FAhmed1I/Telemetry-Board/README.md

Telemetry Tracking PCB for automotive applications. Designed for testing of automotive projects
