FAhmed1I/Telemetry-Board/LGA-14L_STM.step

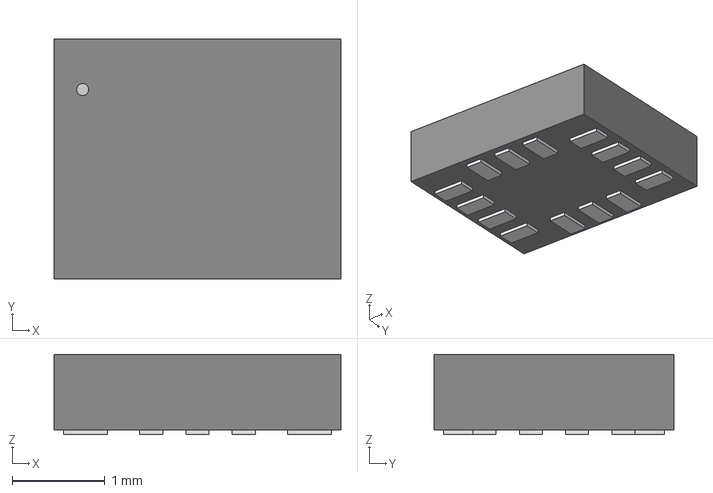
[picture p1: CAD file, 2026-08-17]
LGA-14L_STM.step
3.10 x 2.59 x 0.866 mm
