FAhmed1I/Telemetry-Board/Telemetry Box.kicad_pcb

## KiCad design Telemetry Box.kicad_pcb (2026-09-06)

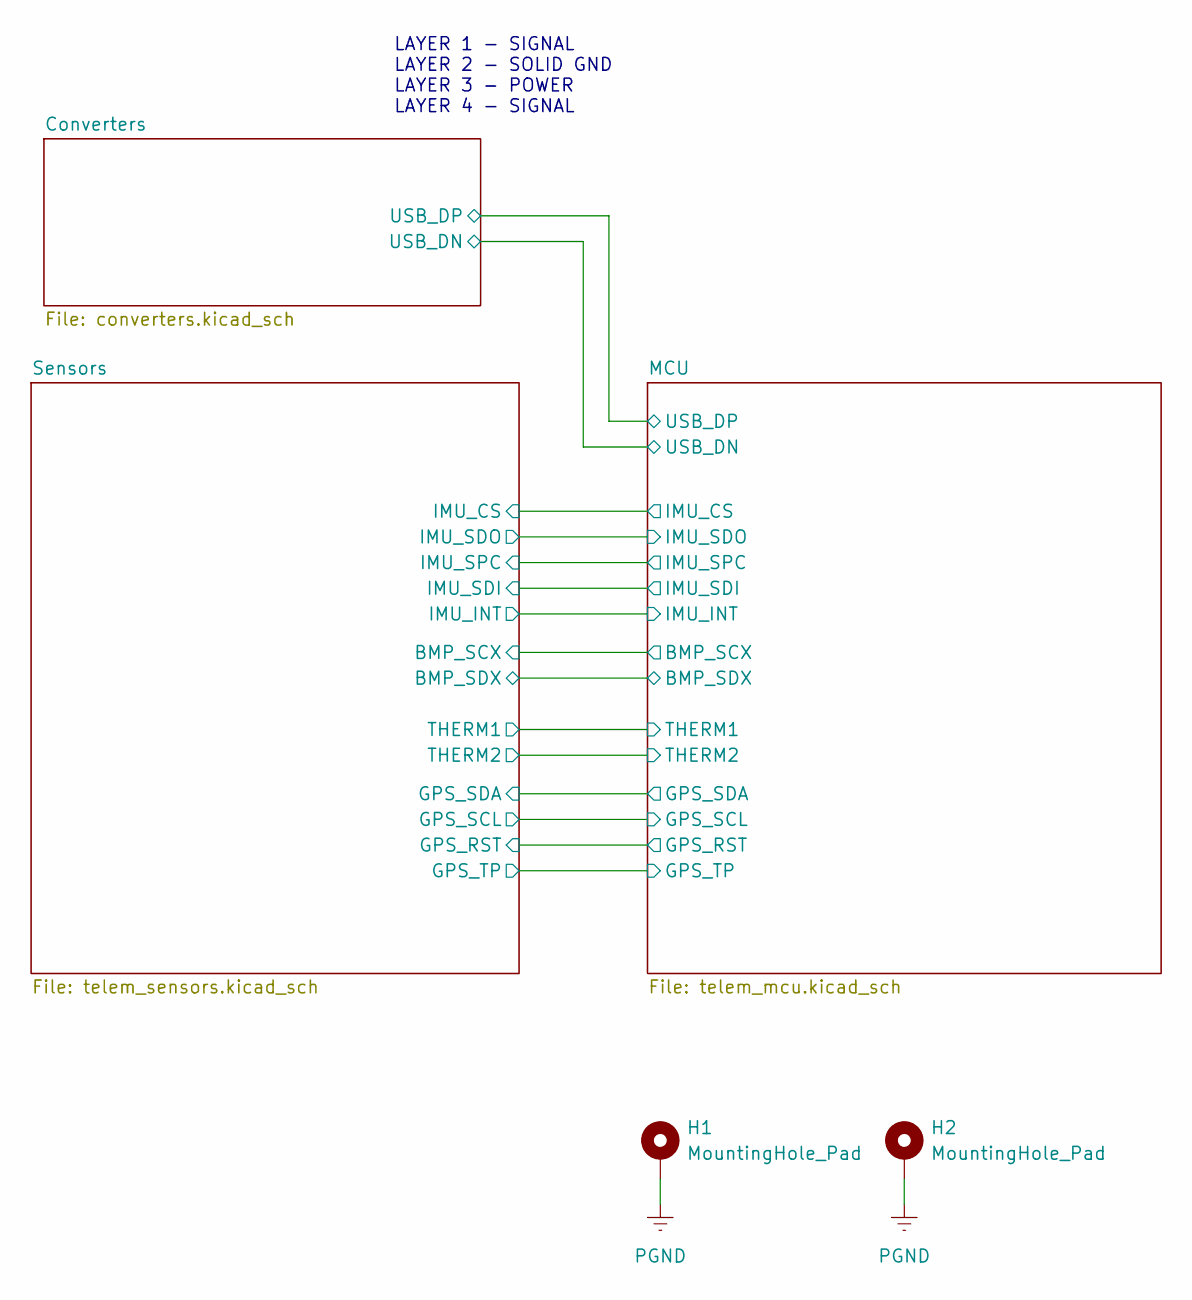
[picture p2: schematic Telemetry Box.kicad_sch]

Parts:
H1, H2: MountingHole_Pad; MountingHole_2.2mm_M2_DIN965_Pad

Connections:
PGND: H1.1 (1_1), H2.1 (1_1); also elsewhere on the board

Notes on the sheet:
LAYER 1 - SIGNAL LAYER 2 - SOLID GND LAYER 3 - POWER LAYER 4 - SIGNAL

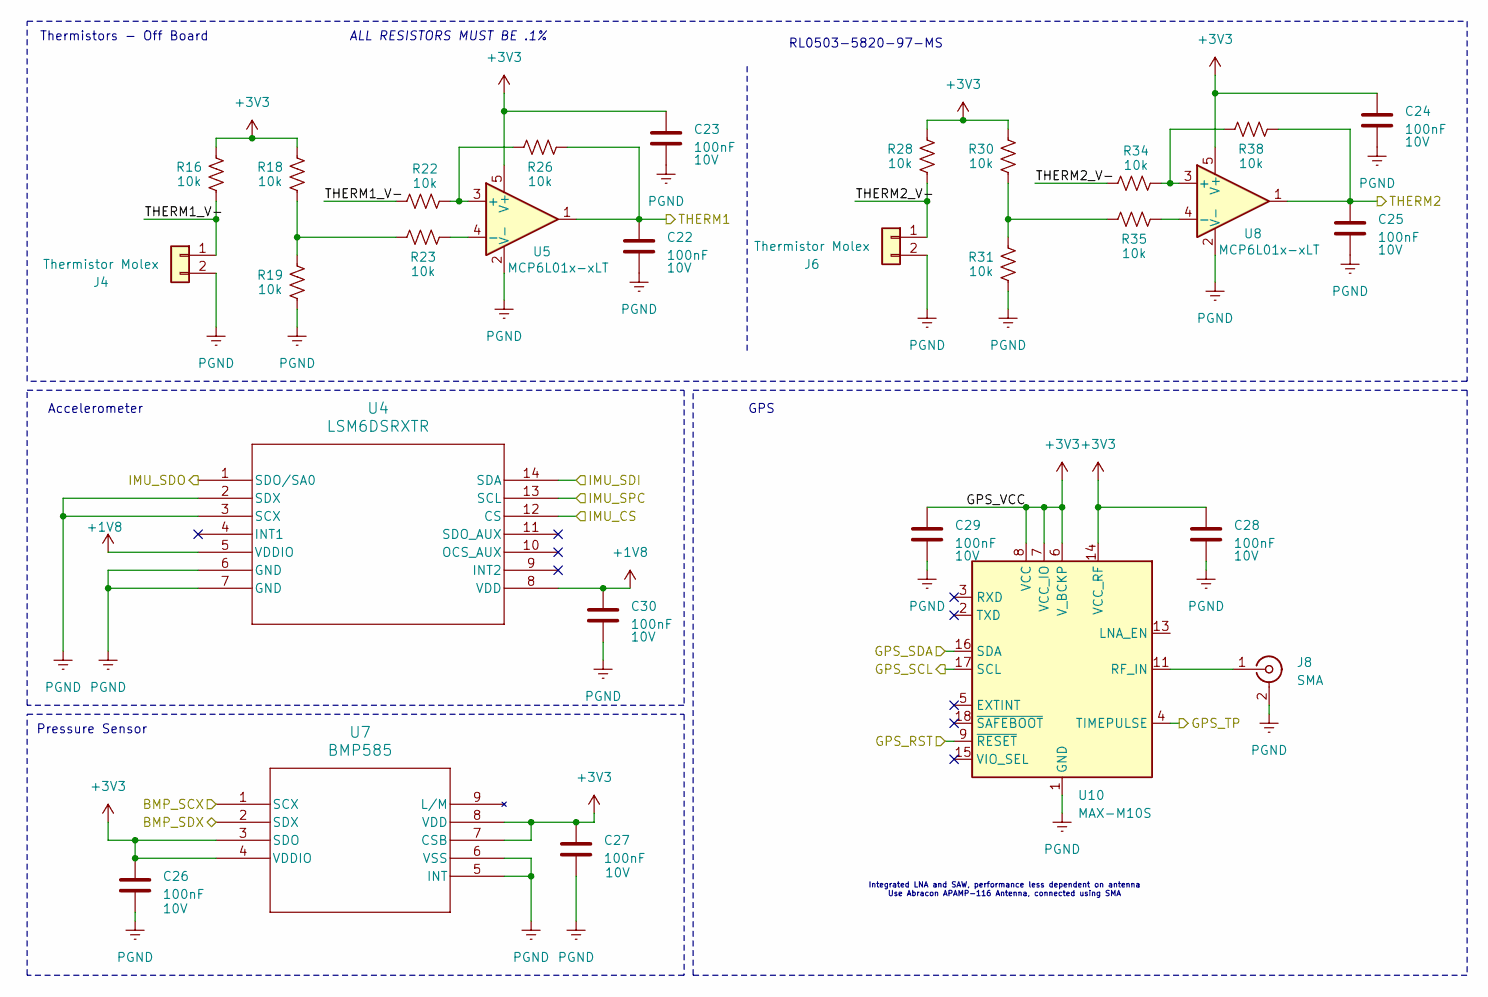
[picture p3: schematic telem_sensors.kicad_sch]

Parts:
C22, C23, C24, C25, C26, C27, C28, C29, C30: 100nF; C_0603_1608Metric; Voltage Rating 10V
J4, J6: Thermistor Molex; Molex_MicroClasp_55932-0230_1x02_P2.00mm_Vertical
J8: SMA; SMA_Amphenol_132289_EdgeMount
R16, R18, R19, R22, R23, R26, R28, R30, R31, R34, R35, R38: 10k; R_0603_1608Metric
U4: LSM6DSRXTR; LGA-14L_STM
U5, U8: MCP6L01x-xLT; SOT-353_SC-70-5
U7: BMP585; LGA9_BMP585_BOS
U10: MAX-M10S; ublox_MAX

Connections:
+1V8: C30.1, U4.5 (VDDIO), U4.8 (VDD); also elsewhere on the board
+3V3: C23.1, C24.1, C26.1, C27.1, C28.1, C29.1, R16.2, R18.2, R28.2, R30.2, U5.5 (V+), U7.3 (SDO), U7.4 (VDDIO), U7.7 (CSB), U7.8 (VDD), U8.5 (V+), U10.6 (V_BCKP), U10.7 (VCC_IO), U10.8 (VCC), U10.14 (VCC_RF); also elsewhere on the board
/MCU/BMP_SCX: U7.1 (SCX); also elsewhere on the board
/MCU/BMP_SDX: U7.2 (SDX); also elsewhere on the board
/MCU/GPS_RST: U10.9 (~RESET); also elsewhere on the board
/MCU/GPS_SCL: U10.17 (SCL); also elsewhere on the board
/MCU/GPS_SDA: U10.16 (SDA); also elsewhere on the board
/MCU/GPS_TP: U10.4 (TIMEPULSE); also elsewhere on the board
/MCU/IMU_CS: U4.12 (CS); also elsewhere on the board
/MCU/IMU_SDI: U4.14 (SDA); also elsewhere on the board
/MCU/IMU_SDO: U4.1 (SDO/SA0); also elsewhere on the board
/MCU/IMU_SPC: U4.13 (SCL); also elsewhere on the board
/MCU/THERM1: C22.1, R26.1, U5.1; also elsewhere on the board
/MCU/THERM2: C25.1, R38.1, U8.1; also elsewhere on the board
/Sensors/THERM1_V-: J4.1, R16.1, R22.2
/Sensors/THERM2_V-: J6.1, R28.1, R34.2
unnamed: J8.1 (In), U10.11 (RF_IN)
unnamed: R18.1, R19.2, R23.2
unnamed: R30.1, R31.2, R35.2
unnamed: R22.1, R26.2, U5.3 (+)
unnamed: R23.1, U5.4 (-)
unnamed: R34.1, R38.2, U8.3 (+)
unnamed: R35.1, U8.4 (-)
PGND: C22.2, C23.2, C24.2, C25.2, C26.2, C27.2, C28.2, C29.2, C30.2, J4.2, J6.2, J8.2 (Ext), R19.1, R31.1, U4.2 (SDX), U4.3 (SCX), U4.6 (GND), U4.7 (GND), U5.2 (V-), U7.5 (INT), U7.6 (VSS), U8.2 (V-), U10.1 (GND), U10.10 (GND), U10.12 (GND); also elsewhere on the board

Notes on the sheet:
RL0503-5820-97-MS
Thermistors - Off Board
Accelerometer
GPS
Integrated LNA and SAW, performance less dependent on antenna Use Abracon APAMP-116 Antenna, connected using SMA
ALL RESISTORS MUST BE .1%
Pressure Sensor

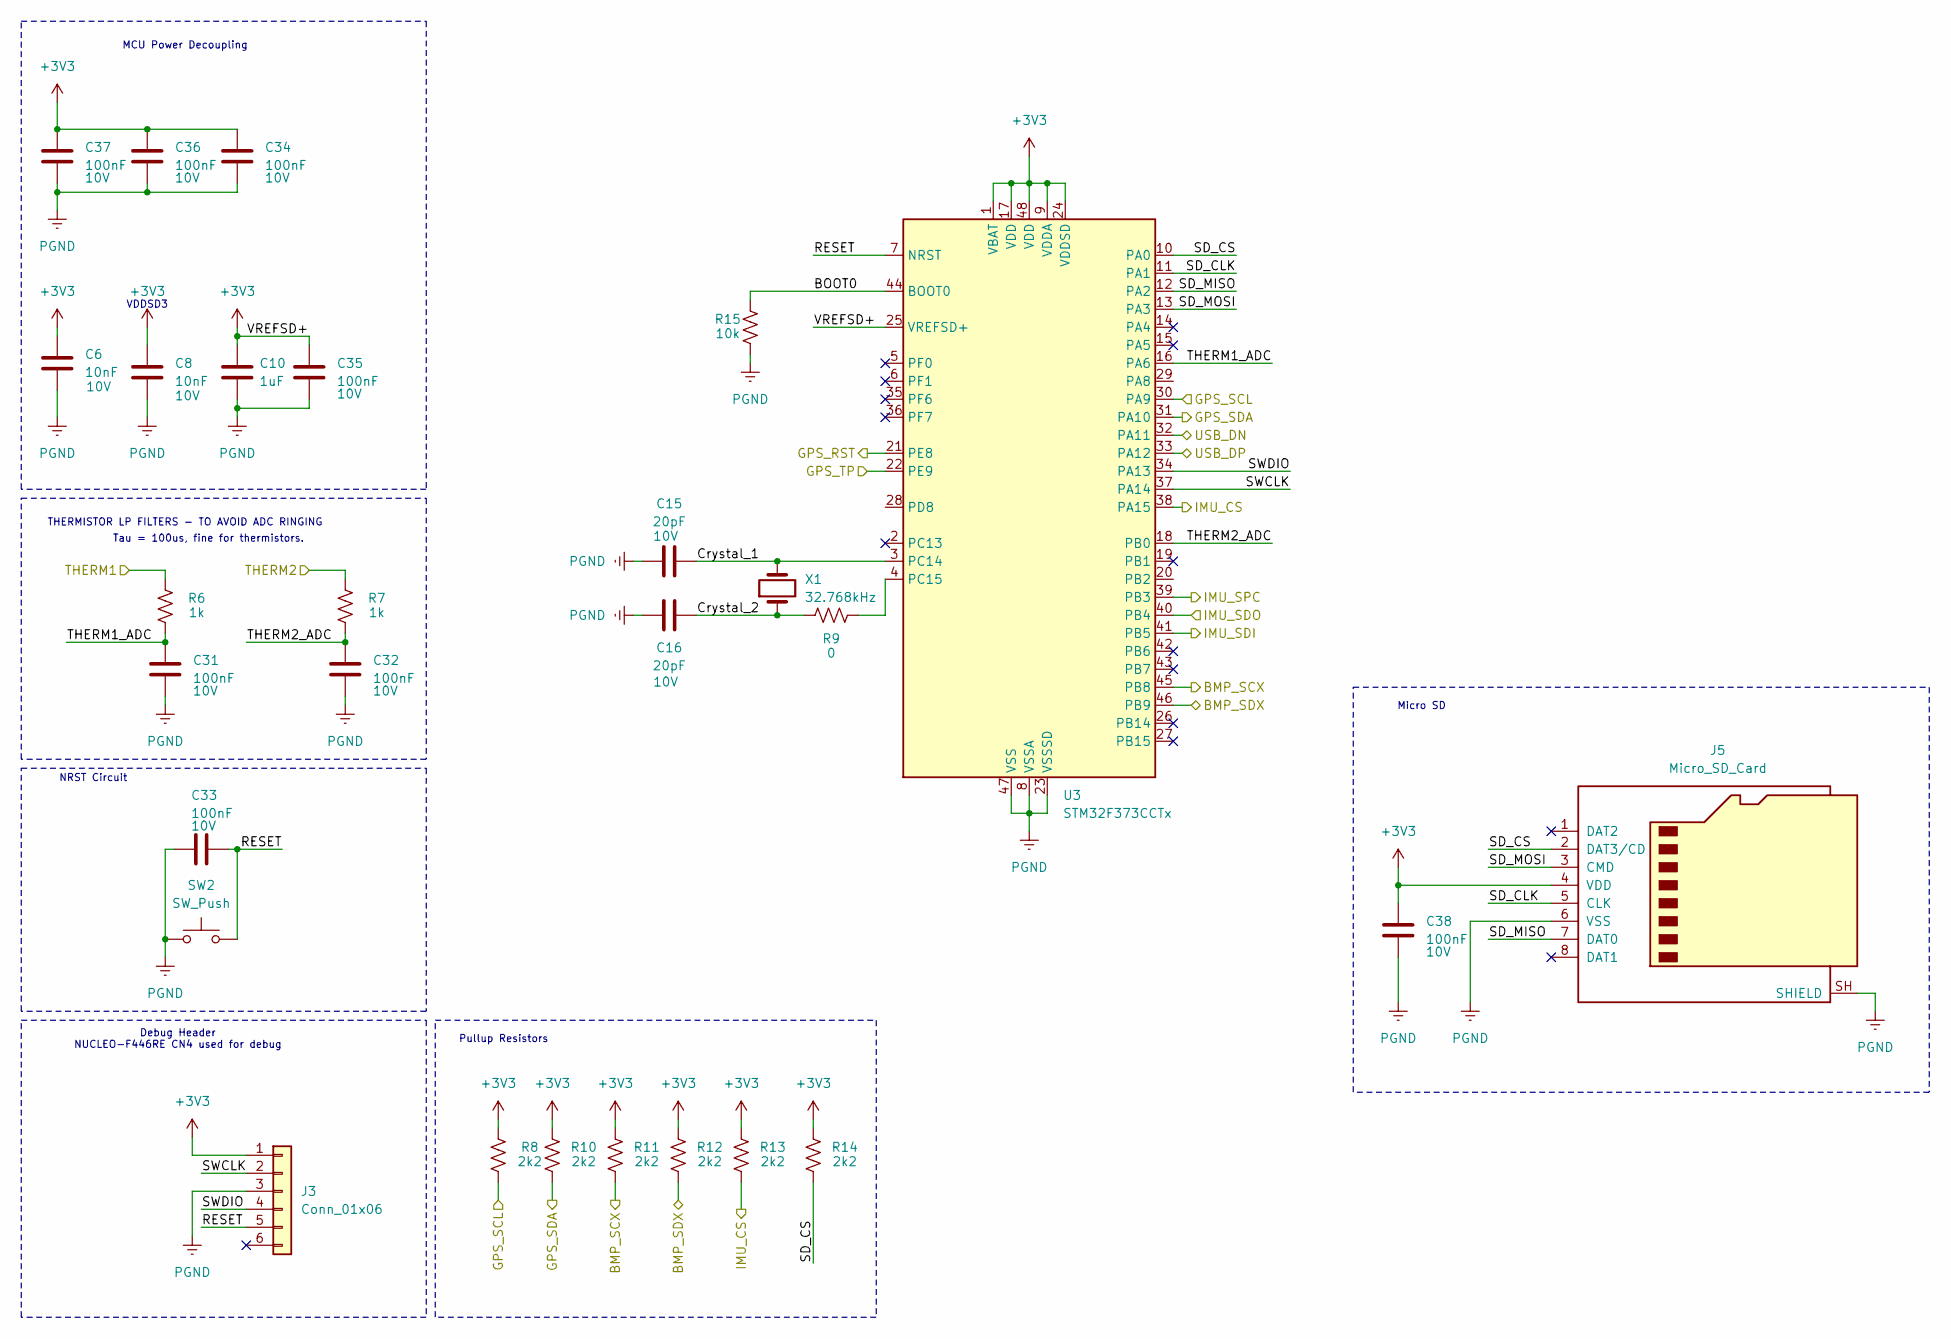
[picture p4: schematic telem_mcu.kicad_sch]

Parts:
C6, C8: 10nF; C_0603_1608Metric; Voltage Rating 10V
C10: 1uF; C_0603_1608Metric; Voltage Rating 10V
C15, C16: 20pF; C_0603_1608Metric; Voltage Rating 10V
C31, C32, C33, C34, C35, C36, C37, C38: 100nF; C_0603_1608Metric; Voltage Rating 10V
J3: Conn_01x06; PinHeader_1x06_P2.54mm_Vertical_SMD_Pin1Right
J5: Micro_SD_Card; AMPHENOL_10067099-200LF
R6, R7: 1k; R_0603_1608Metric
R8, R10, R11, R12, R13, R14: 2k2; R_0603_1608Metric
R9: 0; R_0603_1608Metric
R15: 10k; R_0603_1608Metric
SW2: SW_Push; SW_EVP-AWED4A
U3: STM32F373CCTx; LQFP-48_7x7mm_P0.5mm
X1: 32.768kHz; Crystal_SMD_3215-2Pin_3.2x1.5mm

Connections:
+3V3: C6.1, C8.1, C10.1, C34.1, C35.1, C36.1, C37.1, C38.1, J3.1, J5.4 (VDD), R8.2, R10.2, R11.2, R12.2, R13.2, R14.2, U3.1 (VBAT), U3.9 (VDDA), U3.17 (VDD), U3.24 (VDDSD), U3.25 (VREFSD+), U3.48 (VDD); also elsewhere on the board
/Converters/USB_DN: U3.32 (PA11); also elsewhere on the board
/Converters/USB_DP: U3.33 (PA12); also elsewhere on the board
/MCU/BMP_SCX: R11.1, U3.45 (PB8); also elsewhere on the board
/MCU/BMP_SDX: R12.1, U3.46 (PB9); also elsewhere on the board
/MCU/BOOT0: R15.2, U3.44 (BOOT0)
/MCU/Crystal_1: C15.2, U3.3 (PC14), X1.2
/MCU/Crystal_2: C16.2, R9.1, X1.1
/MCU/GPS_RST: U3.21 (PE8); also elsewhere on the board
/MCU/GPS_SCL: R8.1, U3.30 (PA9); also elsewhere on the board
/MCU/GPS_SDA: R10.1, U3.31 (PA10); also elsewhere on the board
/MCU/GPS_TP: U3.22 (PE9); also elsewhere on the board
/MCU/IMU_CS: R13.1, U3.38 (PA15); also elsewhere on the board
/MCU/IMU_SDI: U3.41 (PB5); also elsewhere on the board
/MCU/IMU_SDO: U3.40 (PB4); also elsewhere on the board
/MCU/IMU_SPC: U3.39 (PB3); also elsewhere on the board
/MCU/RESET: C33.2, J3.5, SW2.2, U3.7 (NRST)
/MCU/SD_CLK: J5.5 (CLK), U3.11 (PA1)
/MCU/SD_CS: J5.2 (DAT3/CD), R14.1, U3.10 (PA0)
/MCU/SD_MISO: J5.7 (DAT0), U3.12 (PA2)
/MCU/SD_MOSI: J5.3 (CMD), U3.13 (PA3)
/MCU/SWCLK: J3.2, U3.37 (PA14)
/MCU/SWDIO: J3.4, U3.34 (PA13)
/MCU/THERM1: R6.2; also elsewhere on the board
/MCU/THERM1_ADC: C31.1, R6.1, U3.16 (PA6)
/MCU/THERM2: R7.2; also elsewhere on the board
/MCU/THERM2_ADC: C32.1, R7.1, U3.18 (PB0)
unnamed: R9.2, U3.4 (PC15)
PGND: C6.2, C8.2, C10.2, C15.1, C16.1, C31.2, C32.2, C33.1, C34.2, C35.2, C36.2, C37.2, C38.2, J3.3, J5.6 (VSS), J5.SH (SHIELD), R15.1, SW2.1, U3.8 (VSSA), U3.23 (VSSSD), U3.47 (VSS); also elsewhere on the board

Notes on the sheet:
Debug Header NUCLEO-F446RE CN4 used for debug
VDDSD3
THERMISTOR LP FILTERS - TO AVOID ADC RINGING
MCU Power Decoupling
Pullup Resistors
Micro SD
NRST Circuit
Tau = 100us, fine for thermistors.

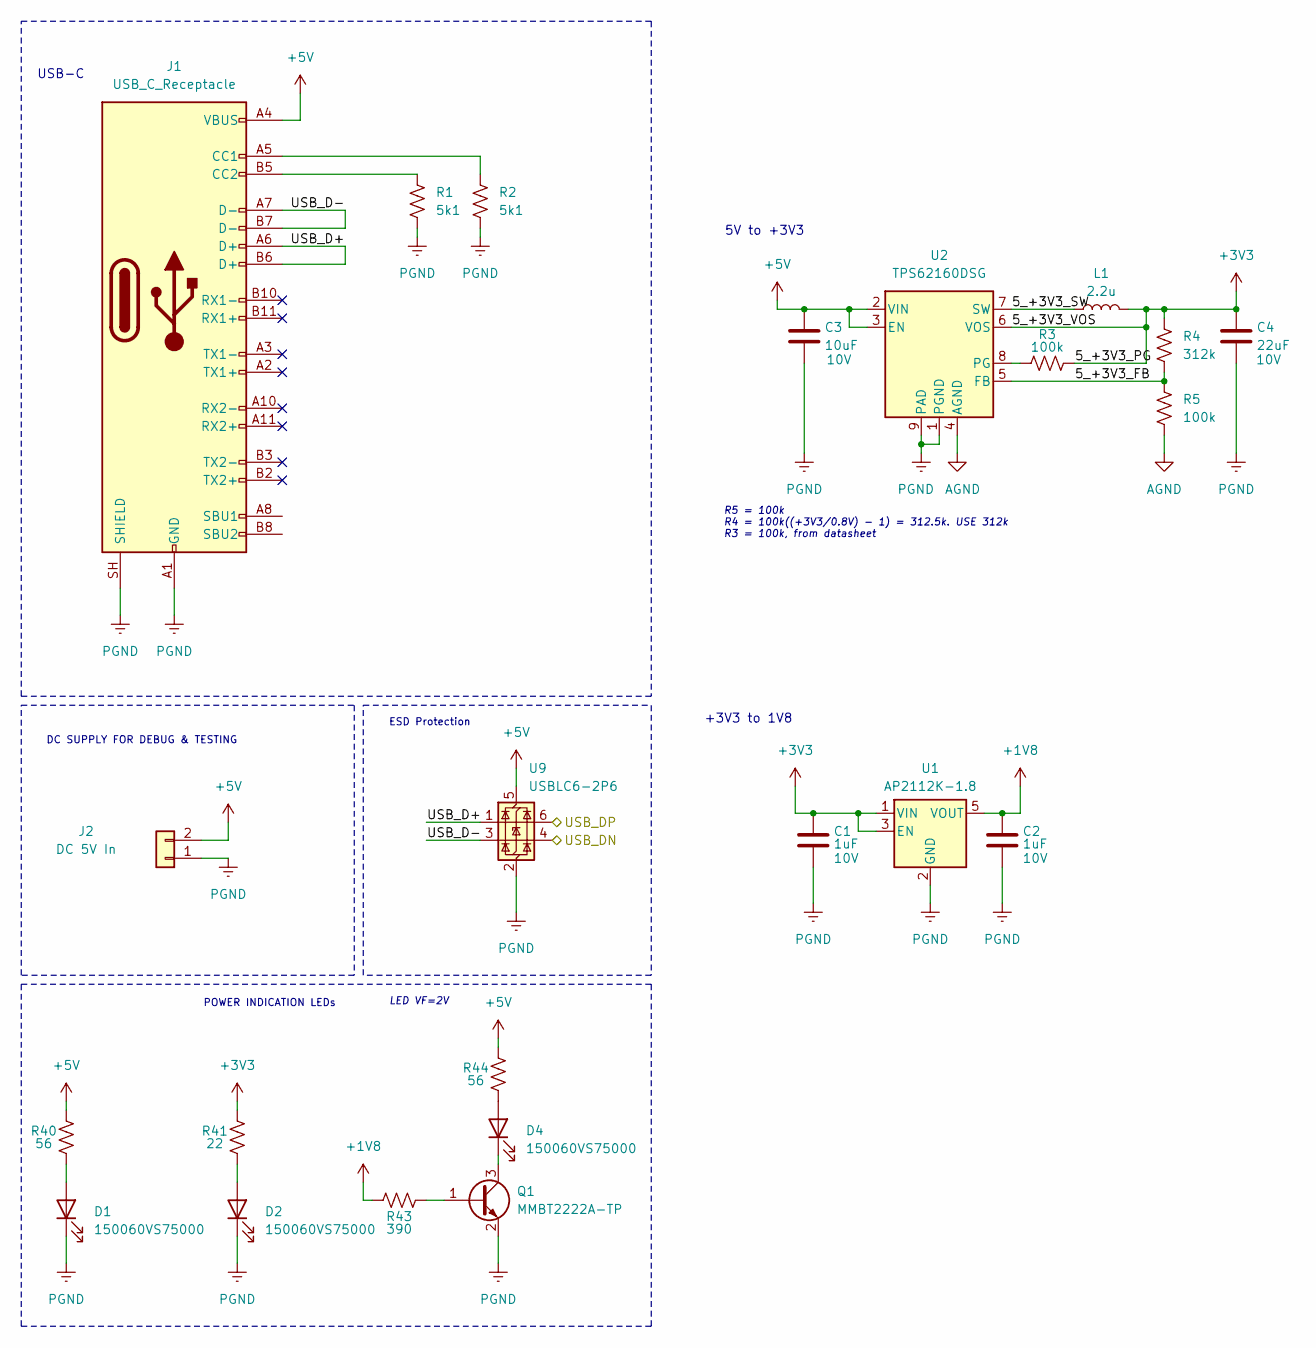
[picture p5: schematic converters.kicad_sch]

Parts:
C1, C2: 1uF; C_0603_1608Metric; Voltage Rating 10V
C3: 10uF; C_0603_1608Metric; Voltage Rating 10V
C4: 22uF; C_0603_1608Metric; Voltage Rating 10V
D1, D2, D4: 150060VS75000; LED_0603_1608Metric
J1: USB_C_Receptacle; USB_C_Receptacle_Amphenol_12401610E4-2A
J2: DC 5V In; PinHeader_1x02_P2.00mm_Vertical
L1: 2.2u; L_1008_2520Metric
Q1: MMBT2222A-TP; SOT-23-3
R1, R2: 5k1; R_0805_2012Metric_Pad1.20x1.40mm_HandSolder
R3, R5: 100k; R_0805_2012Metric_Pad1.20x1.40mm_HandSolder
R4: 312k; R_0805_2012Metric_Pad1.20x1.40mm_HandSolder
R40, R44: 56; R_0603_1608Metric
R41: 22; R_0603_1608Metric
R43: 390; R_0603_1608Metric
U1: AP2112K-1.8; SOT-23-5
U2: TPS62160DSG; WSON-8-1EP_2x2mm_P0.5mm_EP0.9x1.6mm_ThermalVias
U9: USBLC6-2P6; SOT-666

Connections:
+1V8: C2.1, R43.2, U1.5 (VOUT); also elsewhere on the board
+3V3: C1.1, C4.1, L1.2, R3.2, R4.1, R41.2, U1.1 (VIN), U1.3 (EN), U2.6 (VOS); also elsewhere on the board
+5V: C3.1, J1.A4 (VBUS), J1.A9 (VBUS), J1.B4 (VBUS), J1.B9 (VBUS), J2.2, R40.2, R44.2, U2.2 (VIN), U2.3 (EN), U9.5 (VBUS)
/Converters/5_+3V3_FB: R4.2, R5.1, U2.5 (FB)
/Converters/5_+3V3_SW: L1.1, U2.7 (SW)
/Converters/USB_D+: J1.A6 (D+), J1.B6 (D+), U9.1 (I/O1)
/Converters/USB_D-: J1.A7 (D-), J1.B7 (D-), U9.3 (I/O2)
/Converters/USB_DN: U9.4 (I/O2); also elsewhere on the board
/Converters/USB_DP: U9.6 (I/O1); also elsewhere on the board
AGND: R5.2, U2.4 (AGND)
unnamed: D1.2 (A), R40.1
unnamed: D2.2 (A), R41.1
unnamed: D4.2 (A), R44.1
unnamed: D4.1 (K), Q1.3 (C)
unnamed: J1.A5 (CC1), R2.1
unnamed: J1.B5 (CC2), R1.1
unnamed: Q1.1 (B), R43.1
unnamed: R3.1, U2.8 (PG)
PGND: C1.2, C2.2, C3.2, C4.2, D1.1 (K), D2.1 (K), J1.A1 (GND), J1.A12 (GND), J1.B1 (GND), J1.B12 (GND), J1.SH (SHIELD), J2.1, Q1.2 (E), R1.2, R2.2, U1.2 (GND), U2.1 (PGND), U2.9 (PAD), U9.2 (GND); also elsewhere on the board

Notes on the sheet:
+3V3 to 1V8
R5 = 100k R4 = 100k((+3V3/0.8V) - 1) = 312.5k. USE 312k R3 = 100k, from datasheet
LED VF=2V
USB-C
5V to +3V3
DC SUPPLY FOR DEBUG & TESTING
POWER INDICATION LEDs
ESD Protection

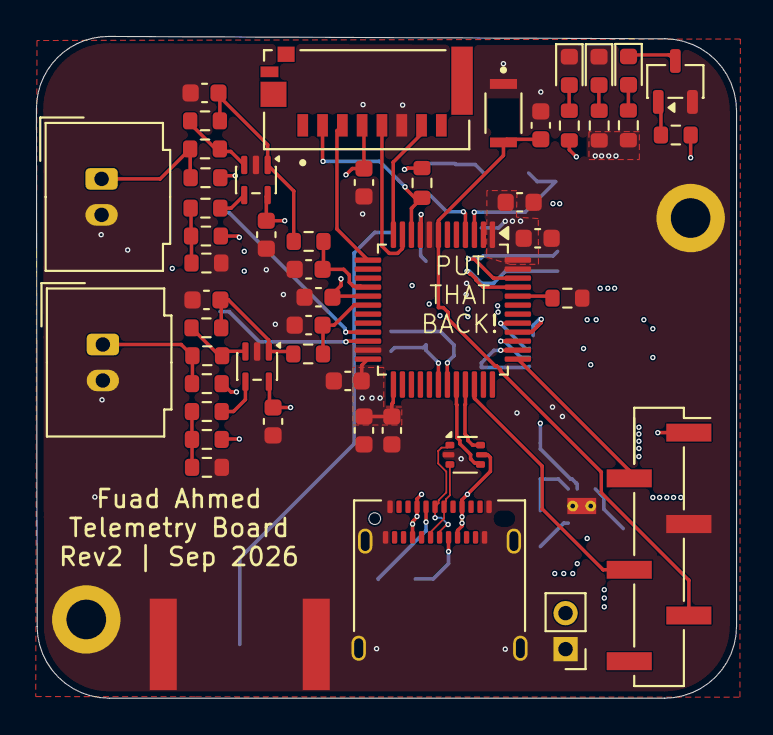
[picture p6: board Telemetry Box.kicad_pcb from above]

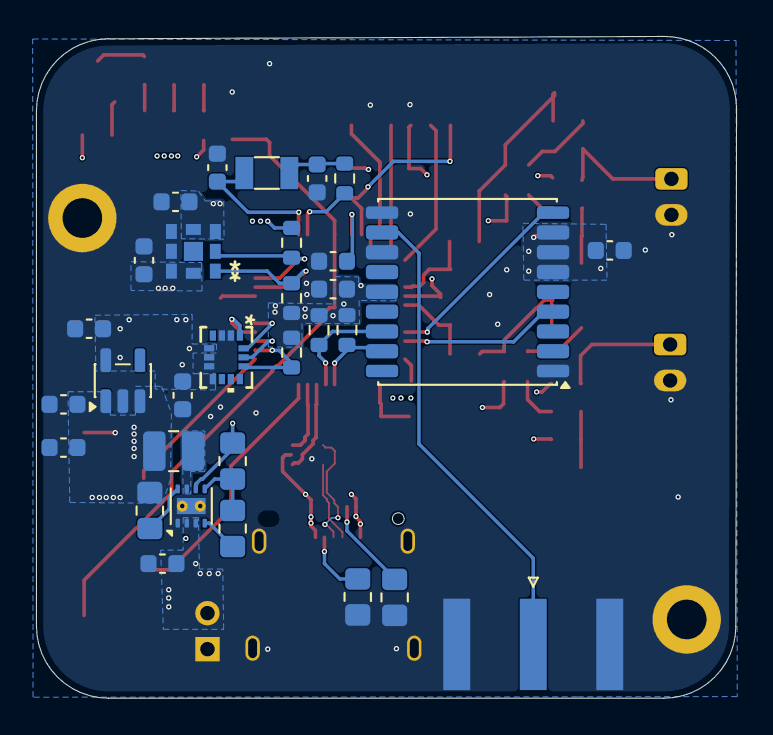
[picture p7: board Telemetry Box.kicad_pcb from below]

Board: 4 copper layers, 38.9 x 36.8 mm, 82 parts (31 on the bottom side), 53 nets.
