FAhmed1I/Telemetry-Board/(commit log)

2026-08-19 Added MAX-M10S GPS, selected antenna and did schematic
    [Telemetry Box.kicad_pcb, converters.kicad_sch, telem_mcu.kicad_sch, telem_sensors.kicad_sch]
2026-08-19 Telem box schematic updates
2026-08-20 Schematics complete; Starting layout. Removed 2 thermistors, not necessary. Going to update website once layout starts
    [Telemetry Box.kicad_pcb, Telemetry Box.kicad_sch, converters.kicad_sch, telem_mcu.kicad_sch, telem_sensors.kicad_sch]
2026-08-22 Final schematic and initial layout
    [LGA9_BMP585_BOS.step, MAX-M10S-00B.STEP, Telemetry Box.kicad_pcb, Telemetry Box.kicad_sch, converters.kicad_sch, telem_mcu.kicad_sch, telem_sensors.kicad_sch]
2026-08-24 Finished initial signal layout
    [EG1215AA.STEP, Telemetry Box.kicad_pcb, Telemetry Box.kicad_sch, converters.kicad_sch, telem_mcu.kicad_sch, telem_sensors.kicad_sch]
2026-08-24 Started power routing
    [Telemetry Box.kicad_pcb]
2026-08-24 Removed 8Mhz Crystal. Not necessary, not using 72MHz. Also simplifies routing
    [Telemetry Box.kicad_pcb, telem_mcu.kicad_sch]
2026-08-24 Completed power routing for Rev0
    [Telemetry Box.kicad_pcb]
2026-08-26 Updated gitignore
    [.step, TELEM_REV0_bom.csv, TELEM_REV0_designators.csv, TELEM_REV0_positions.csv, Telemetry Box.kicad_pcb]
2026-08-28 Updated schematics to add SD, will finish SD next and redo layout
    [converters.kicad_sch, telem_mcu.kicad_sch]
2026-09-01 Updated schematics for rev2
    [Telemetry Box.kicad_pcb, Telemetry Box.kicad_sch, converters.kicad_sch, telem_mcu.kicad_sch, telem_sensors.kicad_sch]
2026-09-04 Initial Layout Rev2
    [Telemetry Box.kicad_pcb, telem_mcu.kicad_sch, telem_sensors.kicad_sch]
2026-09-04 Updated Schematics & finished rev2 layout. Routing left
    [Telemetry Box.kicad_pcb, converters.kicad_sch, telem_mcu.kicad_sch, telem_sensors.kicad_sch]
2026-09-04 Moved buck & LDO to shrink board
    [Telemetry Box.kicad_pcb]
2026-09-04 Shrank board, updated all cap footprints. Updated thermistor headers to be vertical
    [Telemetry Box.kicad_pcb, telem_sensors.kicad_sch]
2026-09-04 Finished Rev2 signal routing
    [Telemetry Box.kicad_pcb]
2026-09-06 Finished Rev2 layout
    [.step, EG1215AA.STEP, EVP-AWED4A.step, LGA9_BMP585_BOS.step, MAX-M10S-00B.STEP, Telemetry Box.kicad_pcb]
2026-09-06 Final Rev2 - Resolved all DRC
    [Telemetry Box.kicad_pcb]
